thetemplar/lwsc_esp8266/windows_lwsc_admin/lwsc_admin/lwsc.jpg

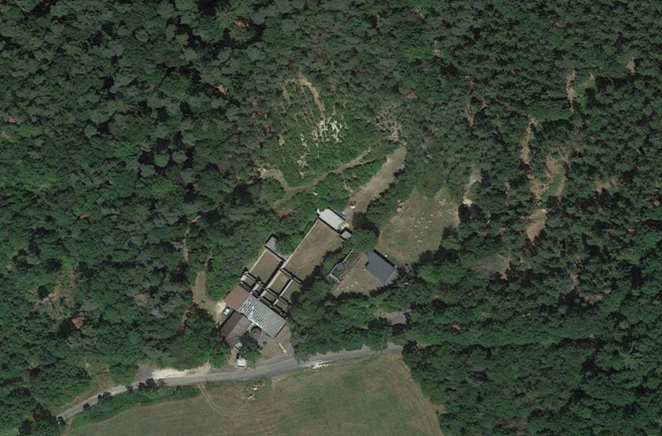
windows_lwsc_admin/lwsc_admin/lwsc.jpg
