thetemplar/lwsc_esp8266/windows_lwsc_admin/lwsc_admin/Resources/lwsc.PNG

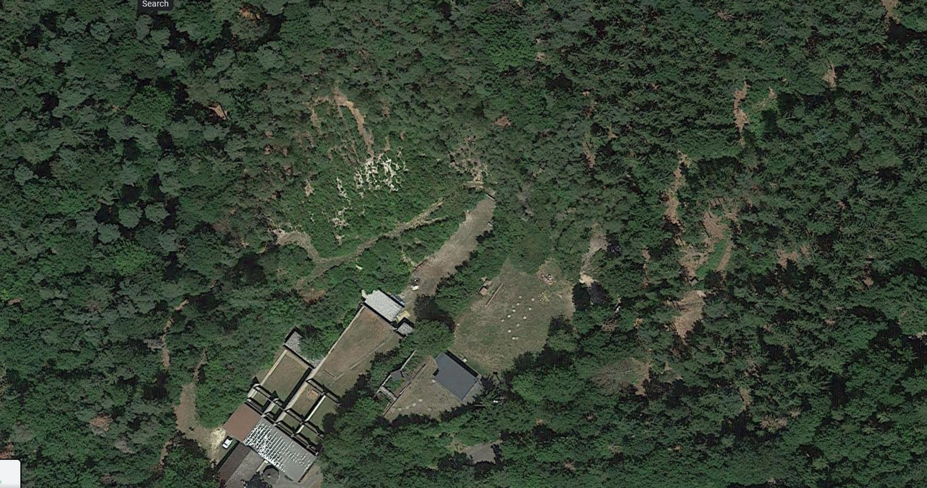
windows_lwsc_admin/lwsc_admin/Resources/lwsc.PNG
