thetemplar/lwsc_esp8266/PBA-URCL-001-01-PT.PDF

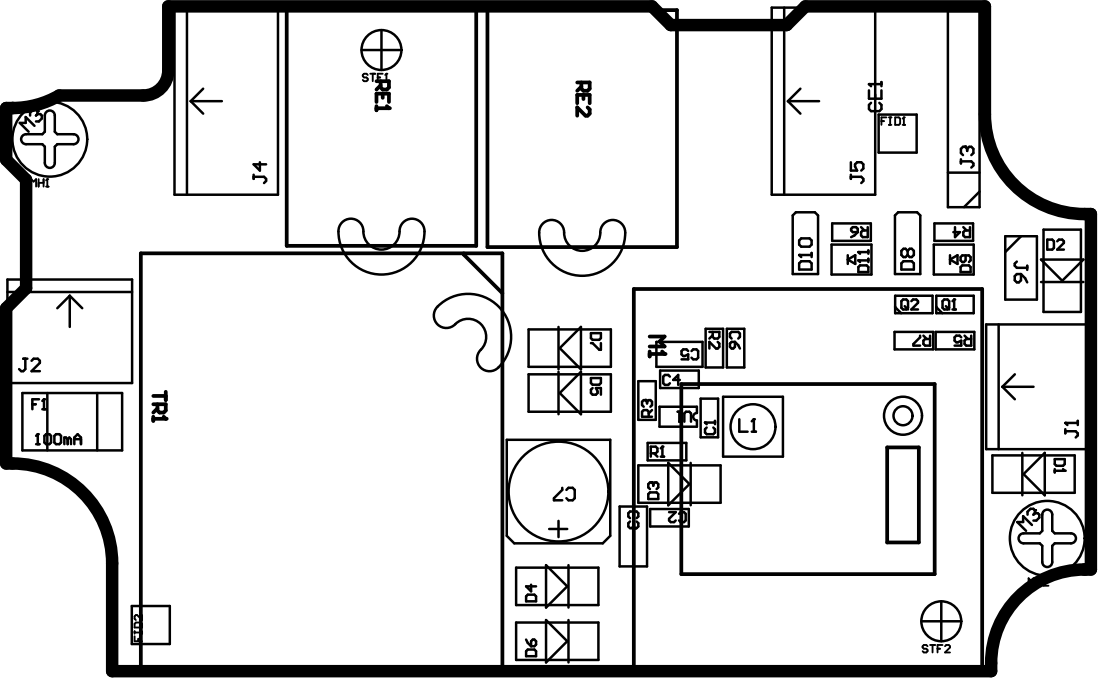
[picture p6: page 1]

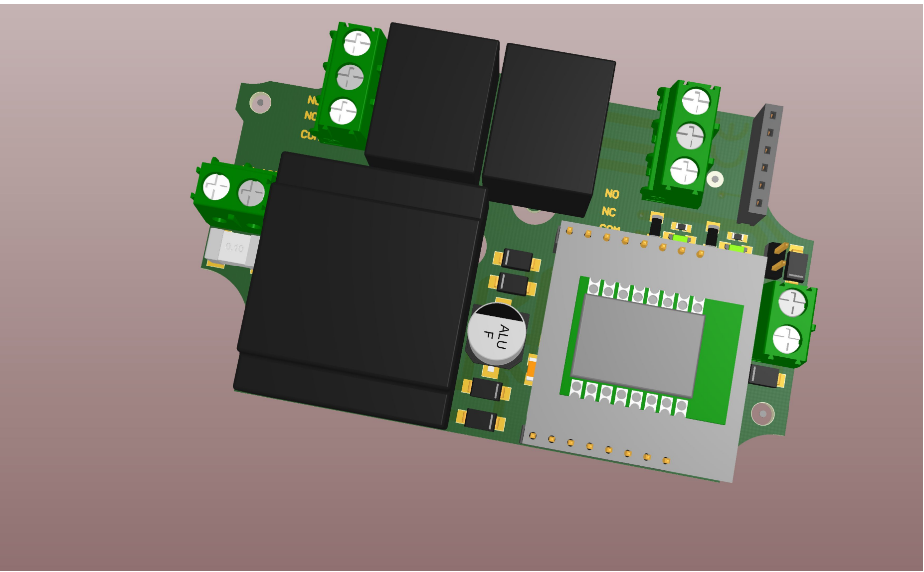
[picture p7: page 2]

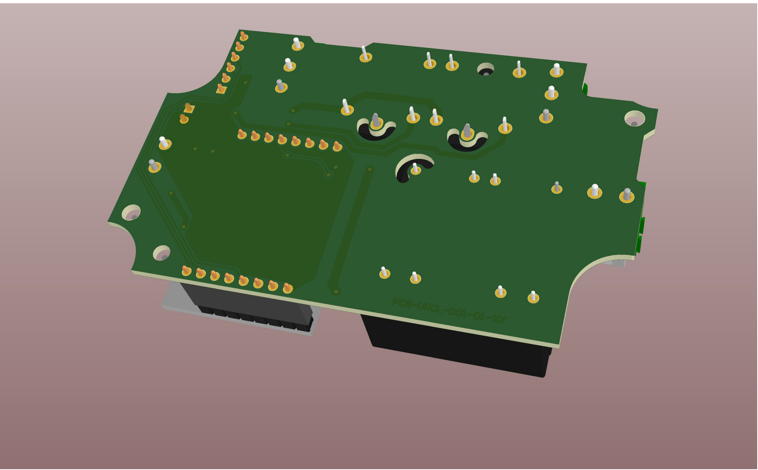
[picture p8: page 3]
