thetemplar/lwsc_esp8266/PBA-URCL-001-01-SC.PDF

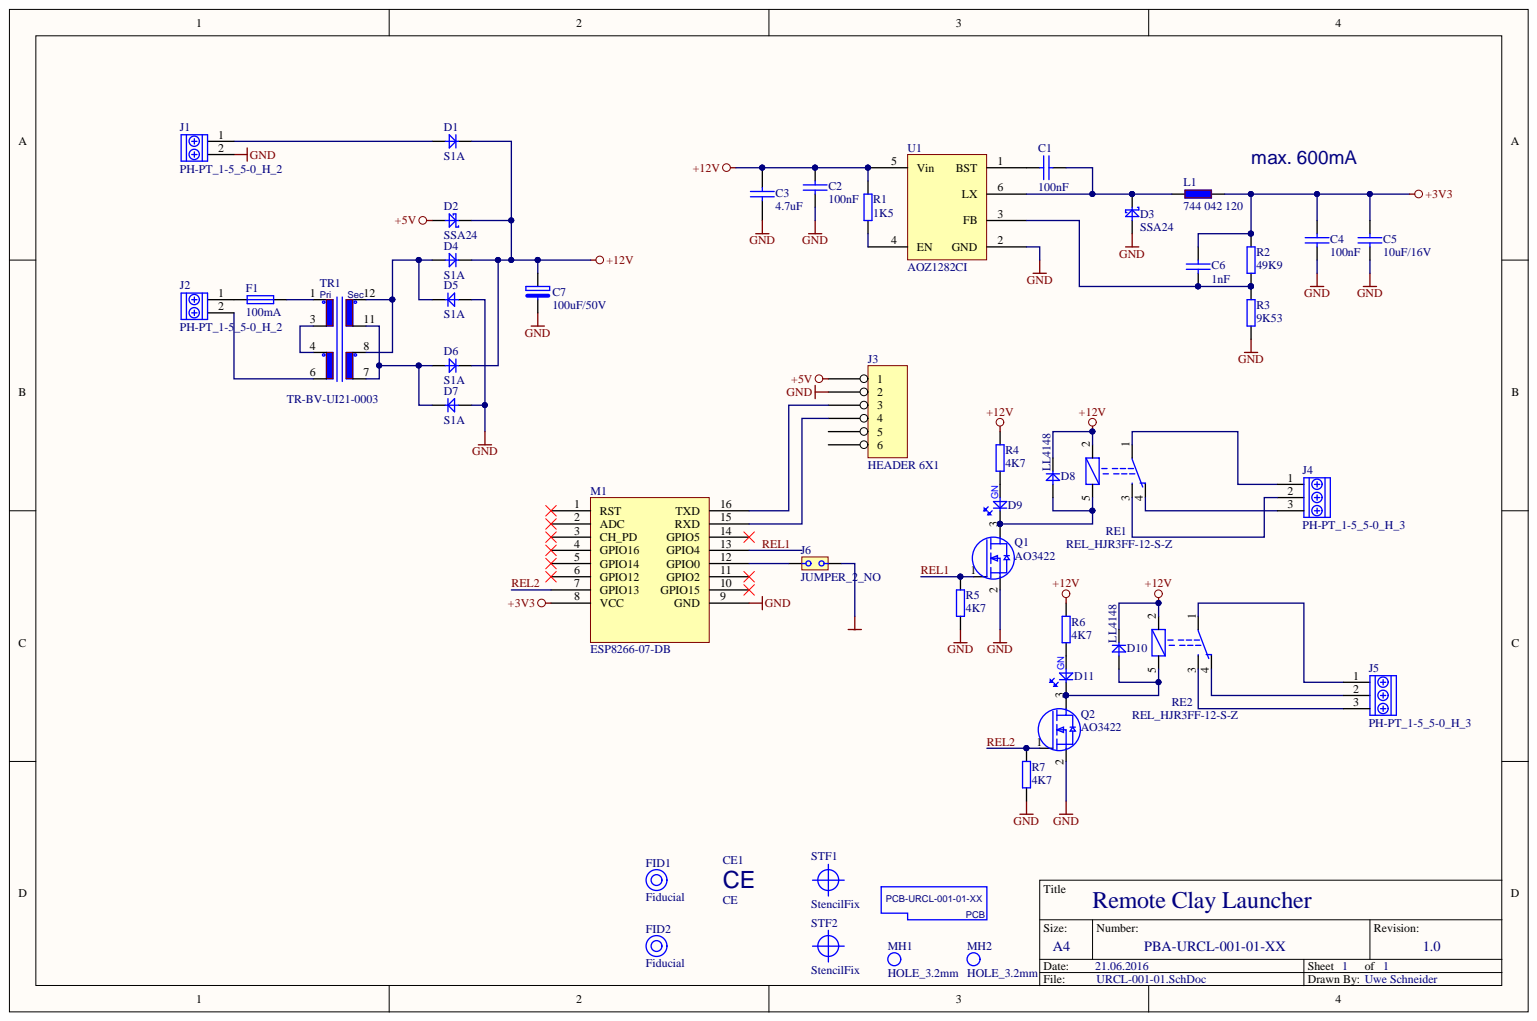
[picture p9: page 1]

Size: A4 | Number: PBA-URCL-001-01-XX | Revision: 1.0

Date: 21.06.2016 | Sheet 1 of 1
File: URCL-001-01.SchDoc | Drawn By: Uwe Schneider
