thetemplar/lwsc_esp8266/gateway_display_ethernet/defines.h

#ifndef DEFINES_H_
#define DEFINES_H_

#pragma once

#include "Arduino.h"

#define VERSION 0x03
//uint8_t VERSION;
#define START_TTL 0x05
#define MSG_TYPE 0x00


struct RxControl {
  signed rssi: 8;
  unsigned rate: 4;
  unsigned is_group: 1;
  unsigned: 1;
  unsigned sig_mode: 2;
  unsigned legacy_length: 12;
  unsigned damatch0: 1;
  unsigned damatch1: 1;
  unsigned bssidmatch0: 1;
  unsigned bssidmatch1: 1;
  unsigned MCS: 7;
  unsigned CWB: 1;
  unsigned HT_length: 16;
  unsigned Smoothing: 1;
  unsigned Not_Sounding: 1;
  unsigned: 1;
  unsigned Aggregation: 1;
  unsigned STBC: 2;
  unsigned FEC_CODING: 1;
  unsigned SGI: 1;
  unsigned rxend_state: 8;
  unsigned ampdu_cnt: 8;
  unsigned channel: 4;
  unsigned: 12;
};

struct LenSeq {
  uint16_t length;
  uint16_t seq;
  uint8_t  address3[6];
};

struct sniffer_buf {
  struct RxControl rx_ctrl;
  uint8_t buf[36];
  uint16_t cnt;
  struct LenSeq lenseq[1];
};

struct sniffer_buf2 {
  struct RxControl rx_ctrl;
  uint8_t buf[112];
  uint16_t cnt;
  uint16_t len;
};

struct msgData {
  uint32_t dst;
  uint32_t src;
  uint32_t trs;
  uint16_t seq;
  uint8_t ver;
  uint8_t ttl;
  uint8_t type;
  uint8_t dataLength;
  uint8_t data[251];
};

enum MsgTypes : uint8_t
{
  MSG_Unknown = 0x00,
  //0x0...  Data
  MSG_Fire = 0x01,
  MSG_Ack = 0x02,
  MSG_Blink = 0x03,
  MSG_Reboot = 0x04,
  //0x1 LoRa Fire Port
  MSG_Lora_Fire_Base = 0x10,
  MSG_Lora_Fire_1 = 0x11,
  MSG_Lora_Fire_2 = 0x12,
  MSG_Lora_Fire_3 = 0x13,
  //0x2... Network
  MSG_RequestRssi = 0x20,
  MSG_SendRssi = 0x21,
  //STM32
  MSG_SetID = 0x40,
  //Misc
  MSG_Version = 0xA0,
  MSG_Version_Reply = 0xA1,
  MSG_RSSI_Ping = 0xAE,
  MSG_RSSI_Ping_Reply = 0xAF,
  //0xE... Input/Sensor
  MSG_Warning_Safety = 0xE0,
  //0xF... System
  MSG_KeepAlive = 0xFA,
  MSG_ERROR = 0xFF
};

enum UserRights {
  None = 0,
  Fire,
  Saves,
  Admin
};

struct User {
  char Name[41];
  char Password[41];
  UserRights Rights;
};

struct MachineFunction {
  char Name[38];
  uint8_t RelaisBitmask;
  int32_t Duration; //-1 = toggle
  
  uint32_t SymbolX;
  uint32_t SymbolY;
  uint8_t Rotation;
};

struct MachineData {
  char Name[38];
  char ShortName[9];
  uint8_t Disabled;
  uint32_t Relais1Counter;
  uint32_t Relais2Counter;

  uint32_t SymbolX;
  uint32_t SymbolY;

  MachineFunction Functions[5];
  
  int8_t Rssi;
  int8_t Snr;
  int8_t MachineRssi;
  int8_t MachineSnr;
  uint64_t LastSeen;
};

#endif
