thetemplar/lwsc_esp8266/gateway_display_ethernet/REST.h

#pragma once

void restServerRouting();
void web_interface();
void rest_get_host();
void rest_get_machine_count();
void rest_get_machine();
void rest_get_search_function();
void rest_post_machine();
void rest_force_fire();
void rest_post_fire();

void rest_get_quality();
void rest_get_all_functions();
void rest_post_function();
void rest_post_blink();
void rest_post_warning();
void rest_get_warning();
void rest_post_reboot();
void rest_upload_handler();
void rest_get_file();
void rest_get_file_list();
void rest_post_save_config();
void rest_get_version();
void rest_delete_file(); 

void rest_get_last_msg();
void rest_get_check_user();

void rest_post_set_relaiscounter();
