thetemplar/lwsc_esp8266/esp8266_lora_test_beacon/esp8266_lora_test_beacon.ino

#include <ESP8266WiFi.h>
#include <ESP8266mDNS.h>
#include <WiFiUdp.h>
#include <ArduinoOTA.h>

#include <LoRaNow.h>

#ifndef STASSID
#define STASSID "lwsc_wifibridge_haupt"
#define STAPSK  "winchester"
#endif

const char* ssid = STASSID;
const char* password = STAPSK;

const int csPin = 2;          // LoRa radio chip select
const int resetPin = 16;       // LoRa radio reset
const int irqPin = 15;         // change for your board; must be a hardware interrupt pin

void setup() {
  Serial.begin(115200);
  Serial.println("Booting");
  //WiFi.mode(WIFI_STA);
  //WiFi.begin(ssid, password);
  //while (WiFi.waitForConnectResult() != WL_CONNECTED) {
  //  Serial.println("Connection Failed! Rebooting...");
  //  delay(5000);
  //  ESP.restart();
  //}

  // Port defaults to 8266
  // ArduinoOTA.setPort(8266);

  // Hostname defaults to esp8266-[ChipID]
  // ArduinoOTA.setHostname("myesp8266");

  // No authentication by default
  // ArduinoOTA.setPassword("admin");

  // Password can be set with it's md5 value as well
  // MD5(admin) = 21232f297a57a5a743894a0e4a801fc3
  // ArduinoOTA.setPasswordHash("21232f297a57a5a743894a0e4a801fc3");

  ArduinoOTA.onStart([]() {
    String type;
    if (ArduinoOTA.getCommand() == U_FLASH) {
      type = "sketch";
    } else { // U_FS
      type = "filesystem";
    }

    // NOTE: if updating FS this would be the place to unmount FS using FS.end()
    Serial.println("Start updating " + type);
  });
  ArduinoOTA.onEnd([]() {
    Serial.println("\nEnd");
  });
  ArduinoOTA.onProgress([](unsigned int progress, unsigned int total) {
    Serial.printf("Progress: %u%%\r", (progress / (total / 100)));
  });
  ArduinoOTA.onError([](ota_error_t error) {
    Serial.printf("Error[%u]: ", error);
    if (error == OTA_AUTH_ERROR) {
      Serial.println("Auth Failed");
    } else if (error == OTA_BEGIN_ERROR) {
      Serial.println("Begin Failed");
    } else if (error == OTA_CONNECT_ERROR) {
      Serial.println("Connect Failed");
    } else if (error == OTA_RECEIVE_ERROR) {
      Serial.println("Receive Failed");
    } else if (error == OTA_END_ERROR) {
      Serial.println("End Failed");
    }
  });
  ArduinoOTA.begin();
  Serial.println("Ready");
  Serial.print("IP address: ");
  Serial.println(WiFi.localIP());

  LoRaNow.setFrequencyCN();
  LoRaNow.setSpreadingFactor(6);
  LoRaNow.setPins(csPin, irqPin);

  if (!LoRaNow.begin()) {
    Serial.println("LoRa init failed. Check your connections.");
    while (true);
  }

  LoRaNow.onMessage(onMessage);
  LoRaNow.onSleep(onSleep);
  LoRaNow.showStatus(Serial);
  
}

void loop() {
  ArduinoOTA.handle();
  LoRaNow.loop();
}


void onMessage(uint8_t *buffer, size_t size)
{
  Serial.print("Receive Message: ");
  Serial.write(buffer, size);
  Serial.println();
  Serial.println();
}

void onSleep()
{
  Serial.println("Sleep");
  delay(5000); // "kind of a sleep"
  Serial.println("Send Message");
  LoRaNow.print("LoRaNow Node Message ");
  LoRaNow.print(millis());
  LoRaNow.send();
}
