thetemplar/lwsc_esp8266/gateway_display_ethernet/DisplayUI.h

#pragma once

#include <Wire.h>
#include "src/esp8266-oled-ssd1306-4.1.0/SH1106Wire.h"

#include "defines.h"
#include "LittleFS.h" // LittleFS is declared


extern MachineData machines[32];
extern int8_t machineCount;

class DisplayUI {
    public:
        // ===== adjustable ===== //
        SH1106Wire display = SH1106Wire(0x3C, 4, 5, GEOMETRY_128_32);
        const uint8_t lineHeight       = 10;
        const uint32_t drawInterval     = 2000; // 100ms = 10 FPS

        void updatePrefix();
        void updateSuffix();
        void drawString(int x, int y, String str);
        void drawString(int row, String str);
        void drawLine(int x1, int y1, int x2, int y2);

        String IpToString(IPAddress ip);
        // ====================== //

        DisplayUI();
        ~DisplayUI();

        void setup();
        void update(bool force = false);        
        void waitForETH();

    private:
      uint32_t drawTime   = 0;   // last time a frame was drawn
};
        
// ===== FONT ===== //
// Created by http://oleddisplay.squix.ch/ Consider a donation
// In case of problems make sure that you are using the font file with the correct version!
const uint8_t DejaVu_Sans_Mono_12[] PROGMEM = {
    0x07,                                                                               // Width: 7
    0x0F,                                                                               // Height: 15
    0x20,                                                                               // First Char: 32
    0xE0,                                                                               // Numbers of Chars: 224

    // Jump Table:
    0xFF, 0xFF, 0x00, 0x07,                                                             // 32:65535
    0x00, 0x00, 0x08, 0x07,                                                             // 33:0
    0x00, 0x08, 0x09, 0x07,                                                             // 34:8
    0x00, 0x11, 0x0D, 0x07,                                                             // 35:17
    0x00, 0x1E, 0x0C, 0x07,                                                             // 36:30
    0x00, 0x2A, 0x0E, 0x07,                                                             // 37:42
    0x00, 0x38, 0x0E, 0x07,                                                             // 38:56
    0x00, 0x46, 0x07, 0x07,                                                             // 39:70
    0x00, 0x4D, 0x0C, 0x07,                                                             // 40:77
    0x00, 0x59, 0x0A, 0x07,                                                             // 41:89
    0x00, 0x63, 0x0B, 0x07,                                                             // 42:99
    0x00, 0x6E, 0x0E, 0x07,                                                             // 43:110
    0x00, 0x7C, 0x08, 0x07,                                                             // 44:124
    0x00, 0x84, 0x0A, 0x07,                                                             // 45:132
    0x00, 0x8E, 0x08, 0x07,                                                             // 46:142
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
  0x00,0x00,0xFC,0x00,0x84,0x00,0x84,0x00,0x78, // 68
  0x00,0x00,0xFC,0x00,0xA4,0x00,0xA4,0x00,0xA4, // 69
  0x00,0x00,0xFC,0x00,0x24,0x00,0x24,0x00,0x24, // 70
  0x00,0x00,0x78,0x00,0x84,0x00,0xA4,0x00,0xE4, // 71
  0x00,0x00,0xFC,0x00,0x20,0x00,0x20,0x00,0xFC, // 72
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
};
