thetemplar/lwsc_esp8266/(commit log)

2021-11-09 Platinen Schematic/Layout
2021-11-18 Added bridge_display and minor fixes to machine.ino
    [DisplayUI.cpp, DisplayUI.h, defines.h, mini_bridge_no_internet.ino]
2021-11-30 Bugfixes, ReqRSSI for 1 machine, re-/set relaiscounter
    [REST.cpp, REST.h]
2021-12-01 Bugfix not exiting Screensaver when no-eth
    [DisplayUI.cpp]
2021-12-02 Bugfix when freshly board is used + added Admin.exe
    [DisplayUI.cpp, REST.cpp]
2021-12-04 Bugfixes, added "ETH"/"WIFI" to UDP:5556
    [REST.cpp, gateway_display_ethernet.ino]
2021-12-08 /web exists + bugfixes + lwsc.conf
    [DisplayUI.cpp, DisplayUI.h, REST.cpp, REST.h, gateway_display_ethernet.ino]
2022-03-24 Bugfix + Remove artefakt
    [REST.cpp, lwsc_lora.cpp]
2022-07-11 Update (Sensor/Warning) + Cleanup
